fabianwimberger/esp32-sovol-sh02-scale/printable/base.stl

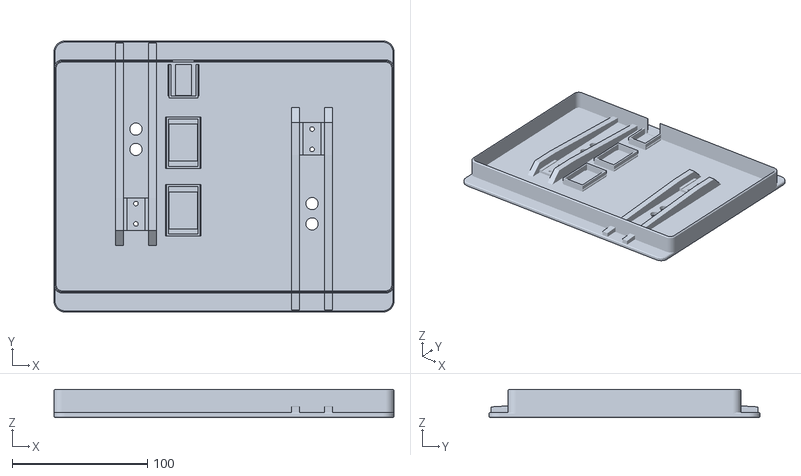
[picture p2: CAD file, 2026-10-15]
printable/base.stl
251.0 x 200.0 x 21.0
