fabianwimberger/esp32-sovol-sh02-scale/printable/esp32_cap.stl

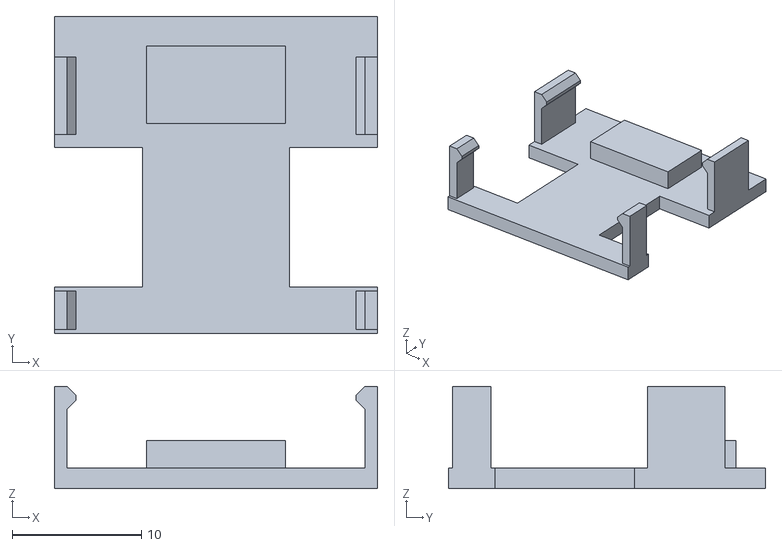
[picture p3: CAD file, 2026-10-15]
printable/esp32_cap.stl
25.0 x 24.6 x 7.90
