fabianwimberger/esp32-sovol-sh02-scale/printable/hx711_cap.stl

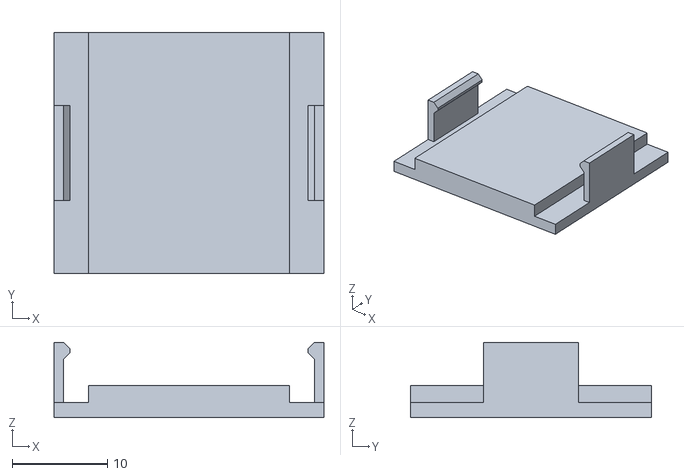
[picture p4: CAD file, 2026-10-15]
printable/hx711_cap.stl
28.4 x 25.3 x 7.90
