fabianwimberger/esp32-sovol-sh02-scale/printable/deck.stl

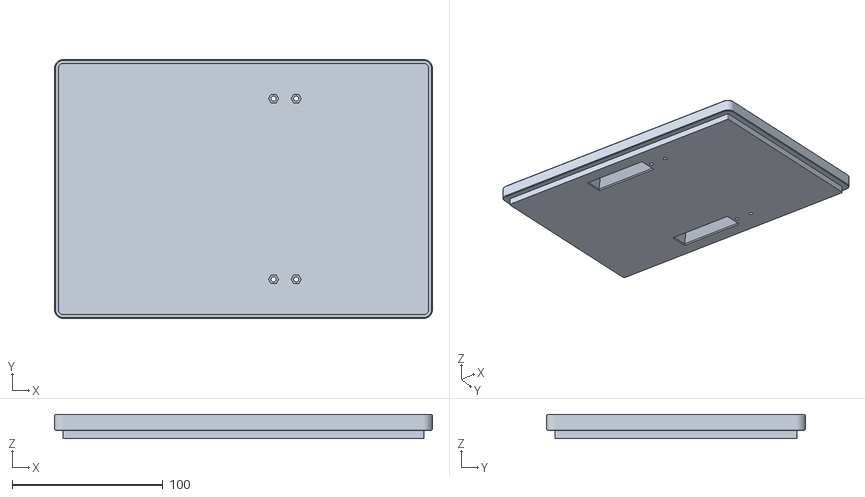
[picture p5: CAD file, 2026-10-15]
printable/deck.stl
251.0 x 172.0 x 16.0
