fabianwimberger/esp32-sovol-sh02-scale/(commit log)

2026-10-15 docs: correct the printed part count (#1)
2026-10-15 feat: turn the load cells across the width (#3)
    Both cells sat side by side along the length, so the top was carried on one transverse line near the middle and cantilevered about 150 mm. The cells now run across the width, one near each end and mirrored, so the two seats sit 130 mm apart along the length.
2026-10-15 fix: keep the cell rails inside the shell wall (#5)
    The rails were sized against the footing width, so they ran out through the shell and stood proud on both long sides. Size them against the shell width instead.
